umamibeef/wifi-modem/README.md

# wifi-modem
 WiFi Modem for Vintage Computers
