umamibeef/wifi-modem/pcb/board-outline.dxf

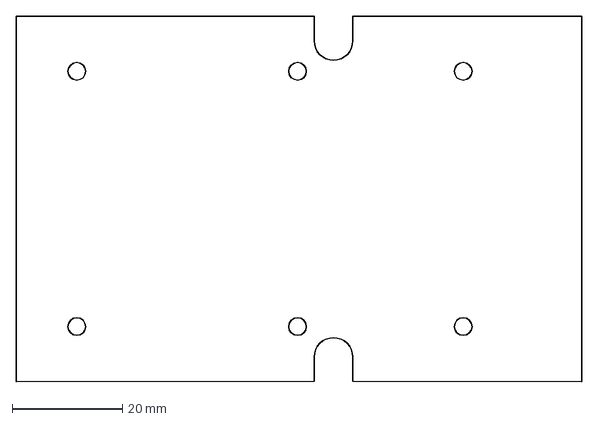
[picture p1: CAD file, 2020-07-17]
pcb/board-outline.dxf
102.5 x 66.1 mm
