umamibeef/wifi-modem/pcb/wifi-modem.pdf

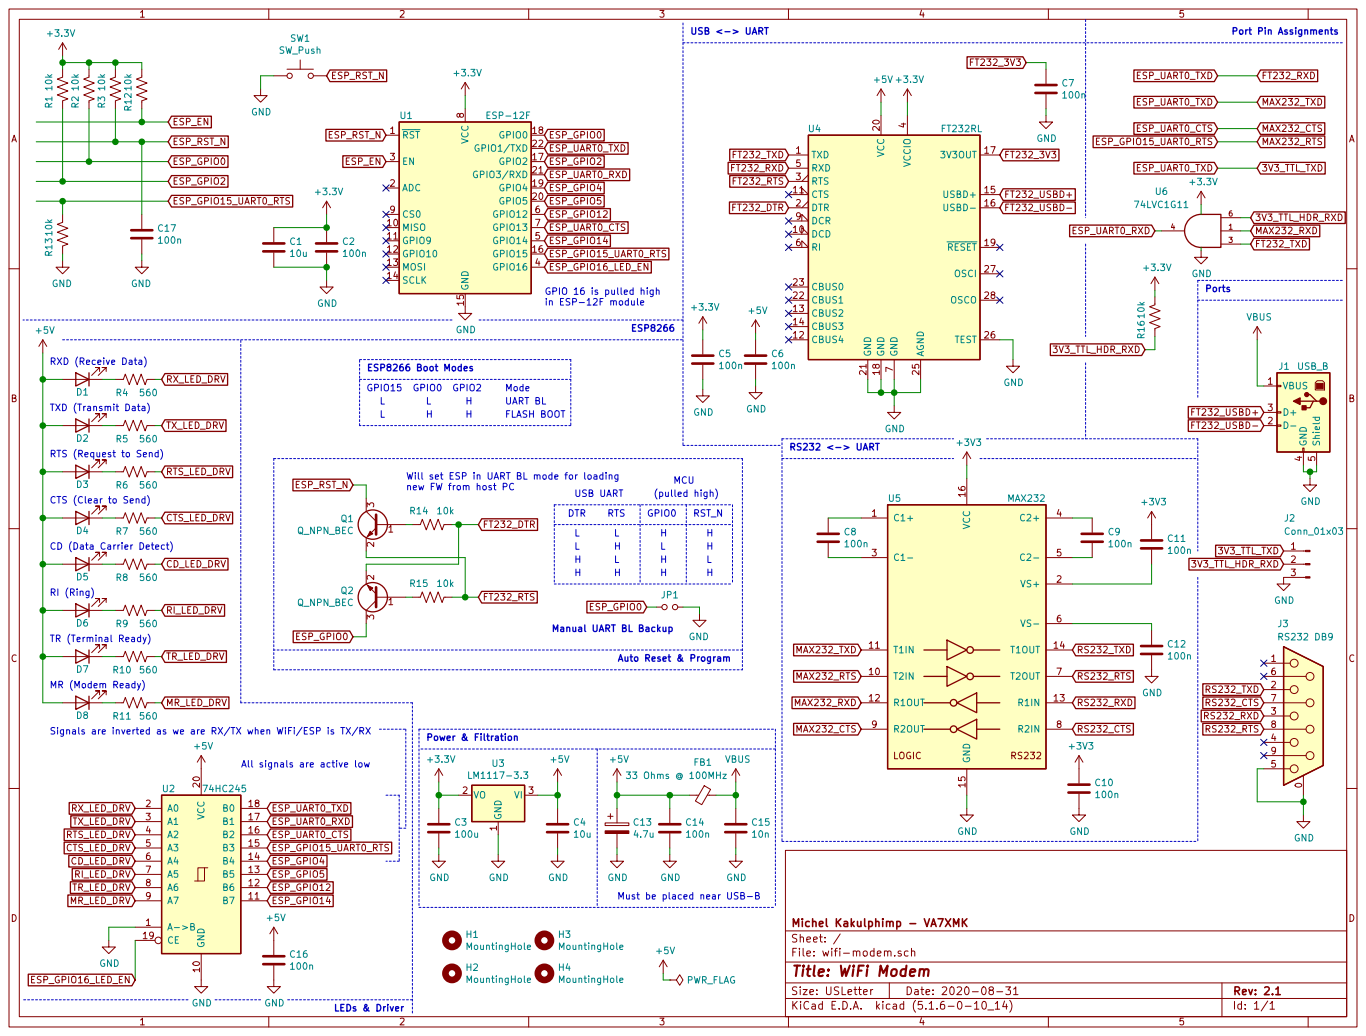
[picture p2: page 1]

GPIO 16 is pulled high

L | RST_N

L Manual UART BL Backup

CD (Data Carrier Detect)

File: wifi-modem.sch Sheet: / Michel Kakulphimp - VA7XMK

Id: 1/1 Title: WiFi Modem
