umamibeef/wifi-modem/pcb/wifi-modem-rev1p1.pdf

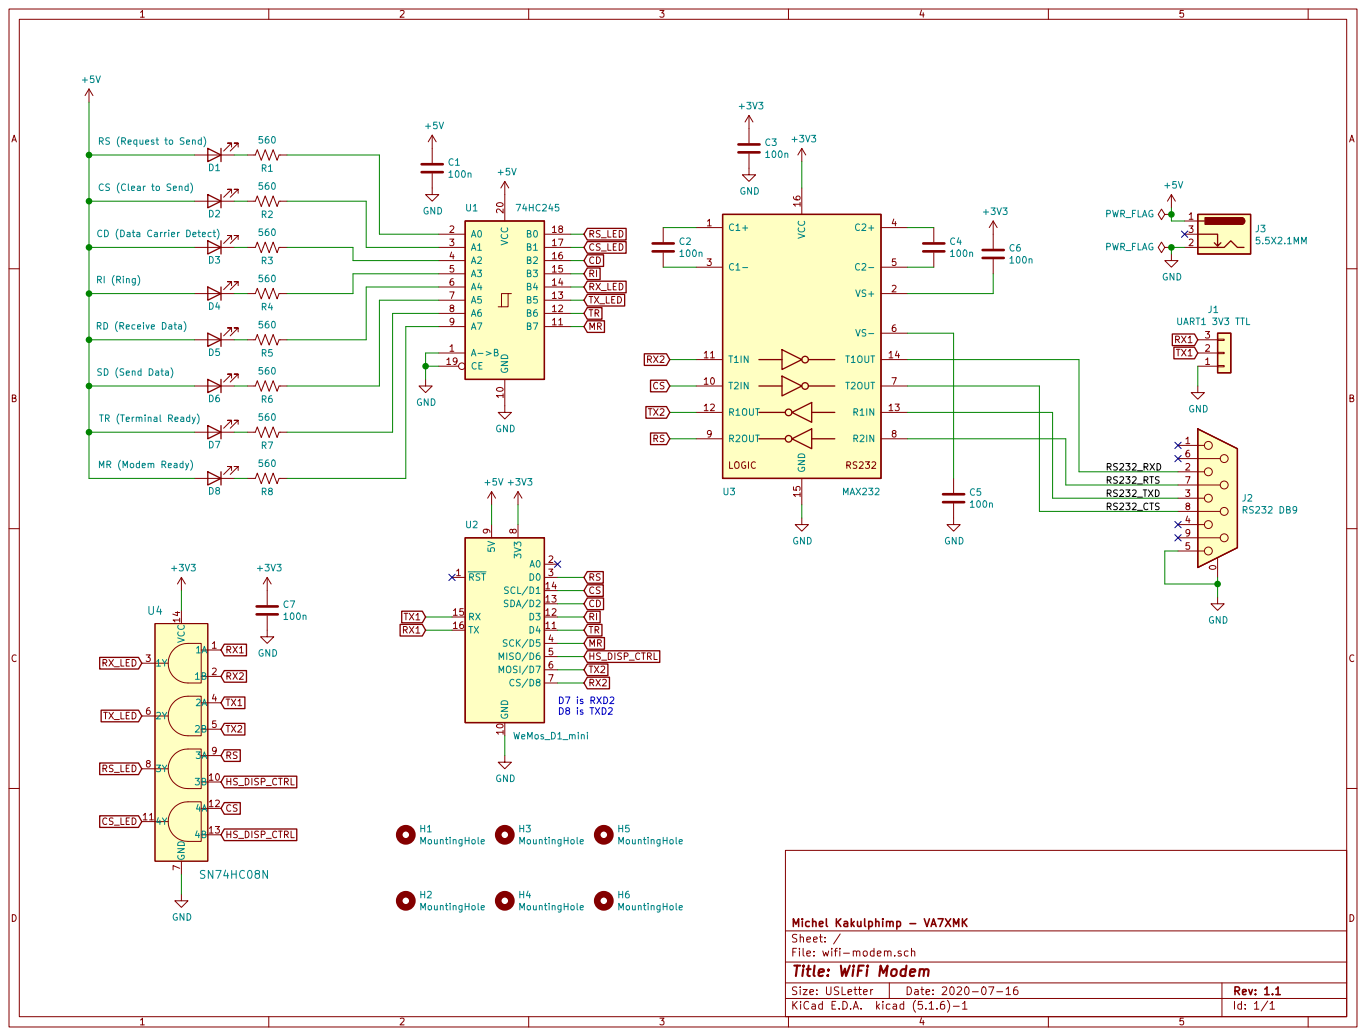
[picture p3: page 1]

File: wifi-modem.sch Sheet: / Michel Kakulphimp - VA7XMK

Id: 1/1 Title: WiFi Modem
