umamibeef/wifi-modem/pcb/wifi-modem.kicad_pcb

## KiCad design pcb/wifi-modem.kicad_pcb (2020-11-01)

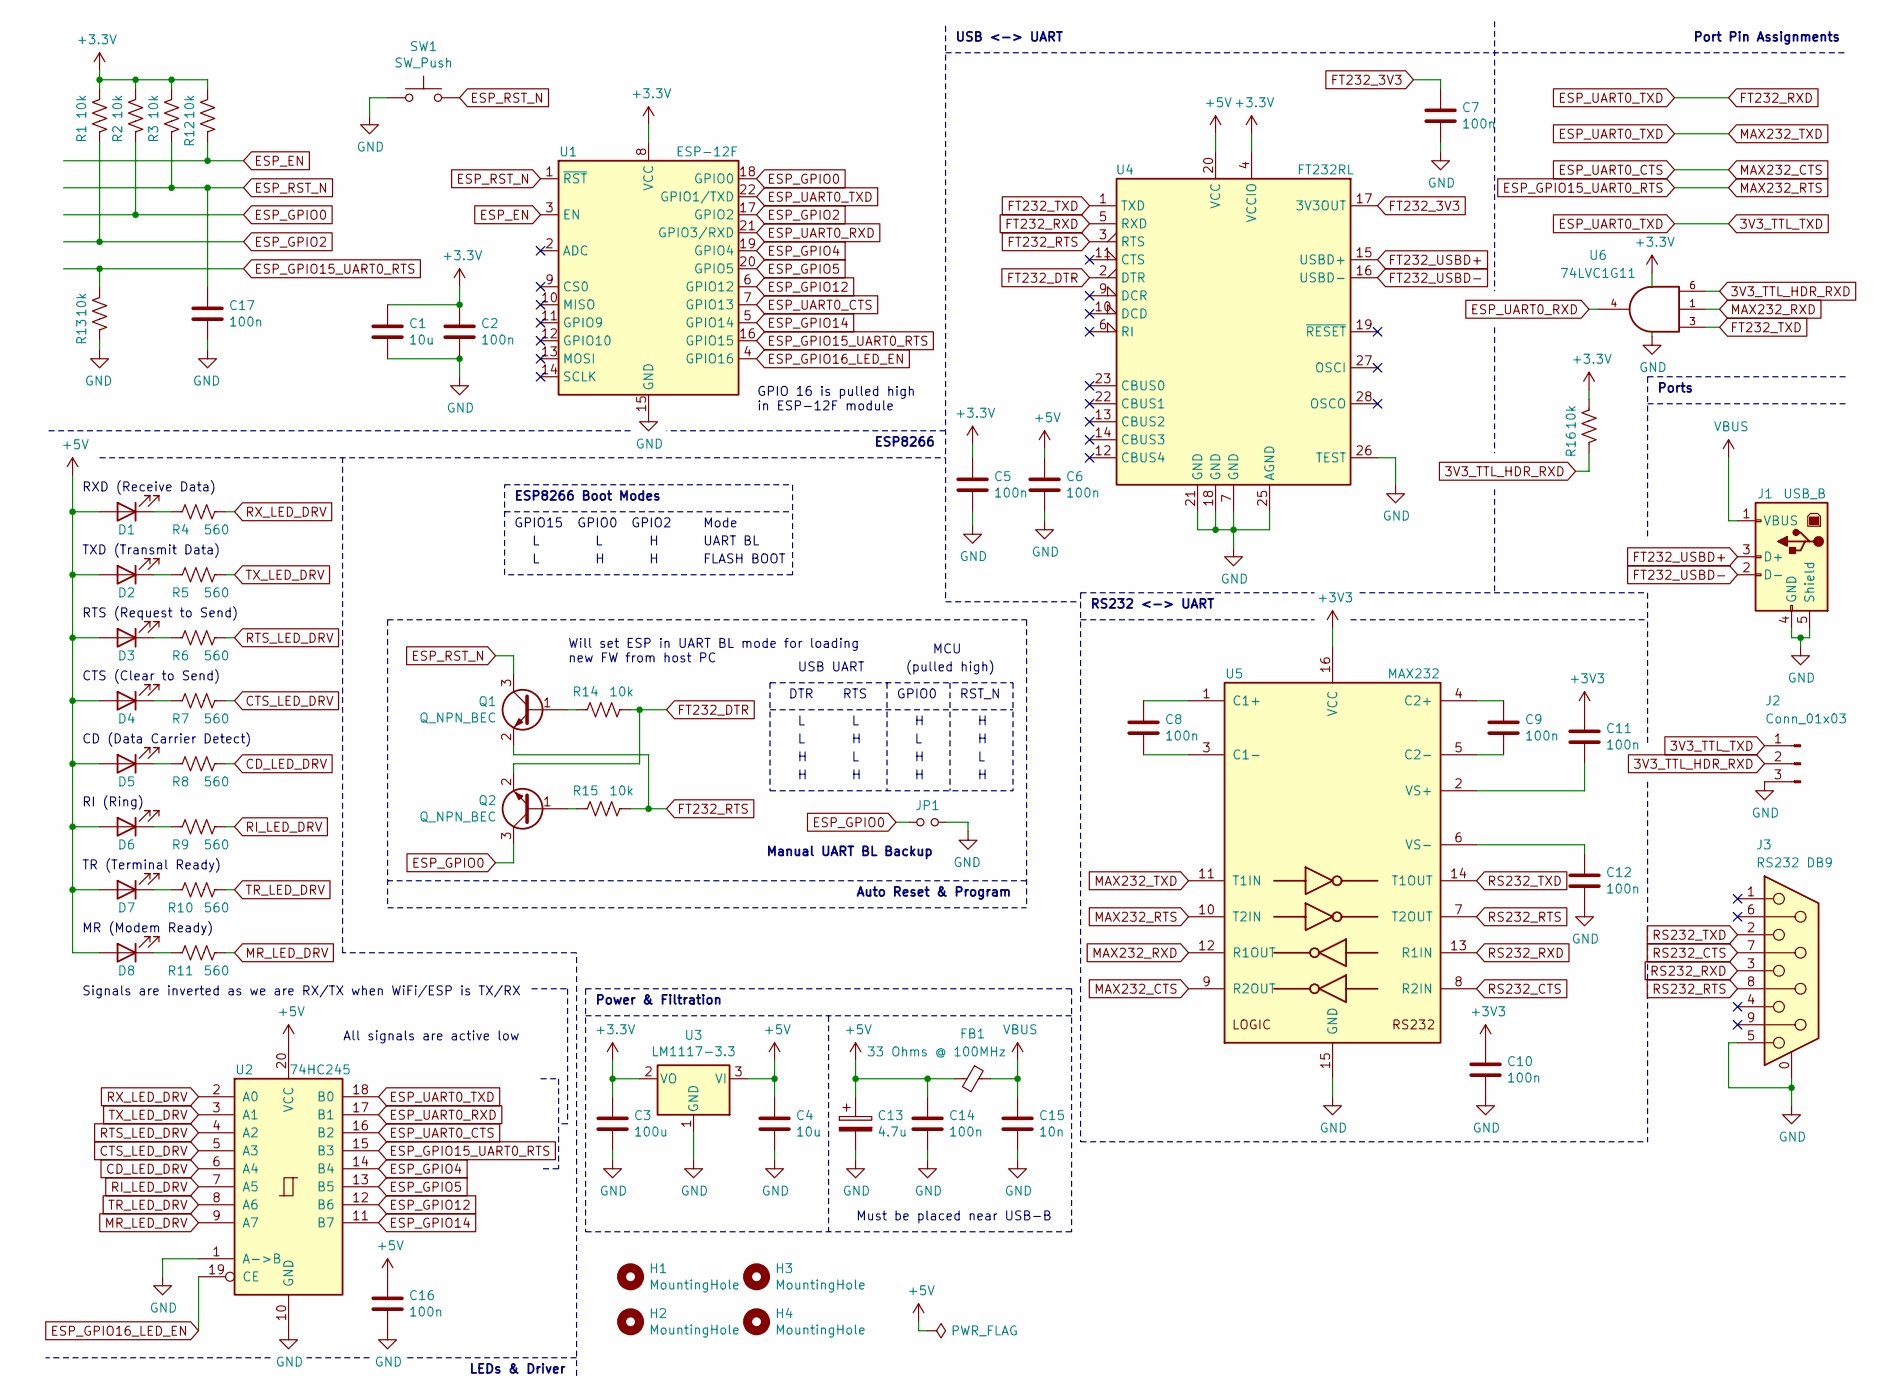
[picture p4: schematic wifi-modem.sch, WiFi Modem]

Parts:
C1, C4: 10u; C_0805_2012Metric_Pad1.15x1.40mm_HandSolder
C2, C5, C6, C7, C8, C9, C10, C11, C12, C14, C16, C17: 100n; C_0805_2012Metric_Pad1.15x1.40mm_HandSolder
C3: 100u; C_0805_2012Metric_Pad1.15x1.40mm_HandSolder
C13: 4.7u; CP_EIA-3216-18_Kemet-A_Pad1.58x1.35mm_HandSolder
C15: 10n; C_0805_2012Metric_Pad1.15x1.40mm_HandSolder
D1, D2, D3, D4, D5, D6, D7, D8: LED; LED_Rectangular_W3.9mm_H1.8mm_FlatTop
FB1: 33 Ohms @ 100MHz; L_0805_2012Metric_Pad1.15x1.40mm_HandSolder
H1, H2, H3, H4: MountingHole; MountingHole_3.2mm_M3
J1: USB_B; USB_B_OST_USB-B1HSxx_Horizontal
J2: Conn_01x03; PinHeader_1x03_P2.54mm_Vertical
J3: RS232 DB9; DSUB-9_Female_Horizontal_P2.77x2.84mm_EdgePinOffset9.90mm_H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
JP1: Jumper_NO_Small; PinHeader_1x02_P2.54mm_Vertical
Q1, Q2: Q_NPN_BEC; SOT-23_Handsoldering
R1, R2, R3, R12, R13, R14, R15, R16: 10k; R_0805_2012Metric_Pad1.15x1.40mm_HandSolder
R4, R5, R6, R7, R8, R9, R10, R11: 560; R_0805_2012Metric_Pad1.15x1.40mm_HandSolder
SW1: SW_Push; SW_SPST_PTS645
U1: ESP-12F; ESP-12E
U2: 74HC245; SOIC-20W_7.5x12.8mm_P1.27mm
U3: LM1117-3.3; SOT-223-3_TabPin2
U4: FT232RL; SSOP-28_5.3x10.2mm_P0.65mm
U5: MAX232; SOIC-16W_7.5x10.3mm_P1.27mm
U6: 74LVC1G11; SOT-23-6_Handsoldering

Connections:
3V3_TTL_HDR_RXD: J2.2, R16.2, U6.6
3V3_TTL_TXD: J2.1, U1.22 (GPIO1/TXD), U2.18 (B0), U4.5 (RXD), U5.11 (T1IN)
+5V: C4.1, C6.1, C13.1, C14.1, C16.1, D1.2 (A), D2.2 (A), D3.2 (A), D4.2 (A), D5.2 (A), D6.2 (A), D7.2 (A), D8.2 (A), FB1.2, U2.20 (VCC), U3.3 (VI), U4.20 (VCC)
CD_LED_DRV: R8.1, U2.6 (A4)
CTS_LED_DRV: R7.1, U2.5 (A3)
ESP_EN: R12.2, U1.3 (EN)
ESP_GPIO0: JP1.1, Q2.3 (C), R2.2, U1.18 (GPIO0)
ESP_GPIO2: R1.2, U1.17 (GPIO2)
ESP_GPIO4: U1.19 (GPIO4), U2.14 (B4)
ESP_GPIO5: U1.20 (GPIO5), U2.13 (B5)
ESP_GPIO12: U1.6 (GPIO12), U2.12 (B6)
ESP_GPIO14: U1.5 (GPIO14), U2.11 (B7)
ESP_GPIO15_UART0_RTS: R13.1, U1.16 (GPIO15), U2.15 (B3), U5.10 (T2IN)
ESP_GPIO16_LED_EN: U1.4 (GPIO16), U2.19 (CE)
ESP_RST_N: C17.1, Q1.3 (C), R3.2, SW1.2, U1.1 (~RST)
ESP_UART0_CTS: U1.7 (GPIO13), U2.16 (B2), U5.9 (R2OUT)
ESP_UART0_RXD: U1.21 (GPIO3/RXD), U2.17 (B1), U6.4
FT232_3V3: C7.1, U4.17 (3V3OUT)
FT232_DTR: Q2.2 (E), R14.2, U4.2 (DTR)
FT232_RTS: Q1.2 (E), R15.2, U4.3 (RTS)
FT232_TXD: U4.1 (TXD), U6.3
FT232_USBD+: J1.3 (D+), U4.15 (USBD+)
FT232_USBD-: J1.2 (D-), U4.16 (USBD-)
GND: C1.2, C2.2, C3.2, C4.2, C5.2, C6.2, C7.2, C10.2, C12.2, C13.2, C14.2, C15.2, C16.2, C17.2, J1.4 (GND), J1.5 (Shield), J2.3, J3.0 (PAD), J3.5, JP1.2, R13.2, SW1.1, U1.15 (GND), U2.1 (A->B), U2.10 (GND), U3.1 (GND), U4.7 (GND), U4.18 (GND), U4.21 (GND), U4.25 (AGND), U4.26 (TEST), U5.15 (GND), U6.2 (GND)
MAX232_RXD: U5.12 (R1OUT), U6.1
MR_LED_DRV: R11.1, U2.9 (A7)
unnamed: C8.1, U5.1 (C1+)
unnamed: C8.2, U5.3 (C1-)
unnamed: C9.1, U5.4 (C2+)
unnamed: C9.2, U5.5 (C2-)
unnamed: C11.2, U5.2 (VS+)
unnamed: C12.1, U5.6 (VS-)
unnamed: D1.1 (K), R4.2
unnamed: D2.1 (K), R5.2
unnamed: D3.1 (K), R6.2
unnamed: D4.1 (K), R7.2
unnamed: D5.1 (K), R8.2
unnamed: D6.1 (K), R9.2
unnamed: D7.1 (K), R10.2
unnamed: D8.1 (K), R11.2
unnamed: Q1.1 (B), R14.1
unnamed: Q2.1 (B), R15.1
RI_LED_DRV: R9.1, U2.7 (A5)
RS232_CTS: J3.7, U5.8 (R2IN)
RS232_RTS: J3.8, U5.7 (T2OUT)
RS232_RXD: J3.3, U5.13 (R1IN)
RS232_TXD: J3.2, U5.14 (T1OUT)
RTS_LED_DRV: R6.1, U2.4 (A2)
RX_LED_DRV: R4.1, U2.2 (A0)
TR_LED_DRV: R10.1, U2.8 (A6)
TX_LED_DRV: R5.1, U2.3 (A1)
VBUS: C15.1, FB1.1, J1.1 (VBUS)

Notes on the sheet:
MR (Modem Ready)
TR (Terminal Ready)
TXD (Transmit Data)
RXD (Receive Data)
RI (Ring)
CD (Data Carrier Detect)
CTS (Clear to Send)
RTS (Request to Send)
GPIO15
GPIO0
GPIO2
Mode
UART BL
FLASH BOOT
Auto Reset & Program
ESP8266 Boot Modes
RST_N
RTS
DTR
Signals are inverted as we are RX/TX when WiFi/ESP is TX/RX
All signals are active low
MCU
USB UART
Will set ESP in UART BL mode for loading new FW from host PC
(pulled high)
Power & Filtration
Must be placed near USB-B
Port Pin Assignments
Ports
ESP8266
LEDs & Driver
USB <-> UART
RS232 <-> UART
GPIO 16 is pulled high in ESP-12F module
Manual UART BL Backup

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
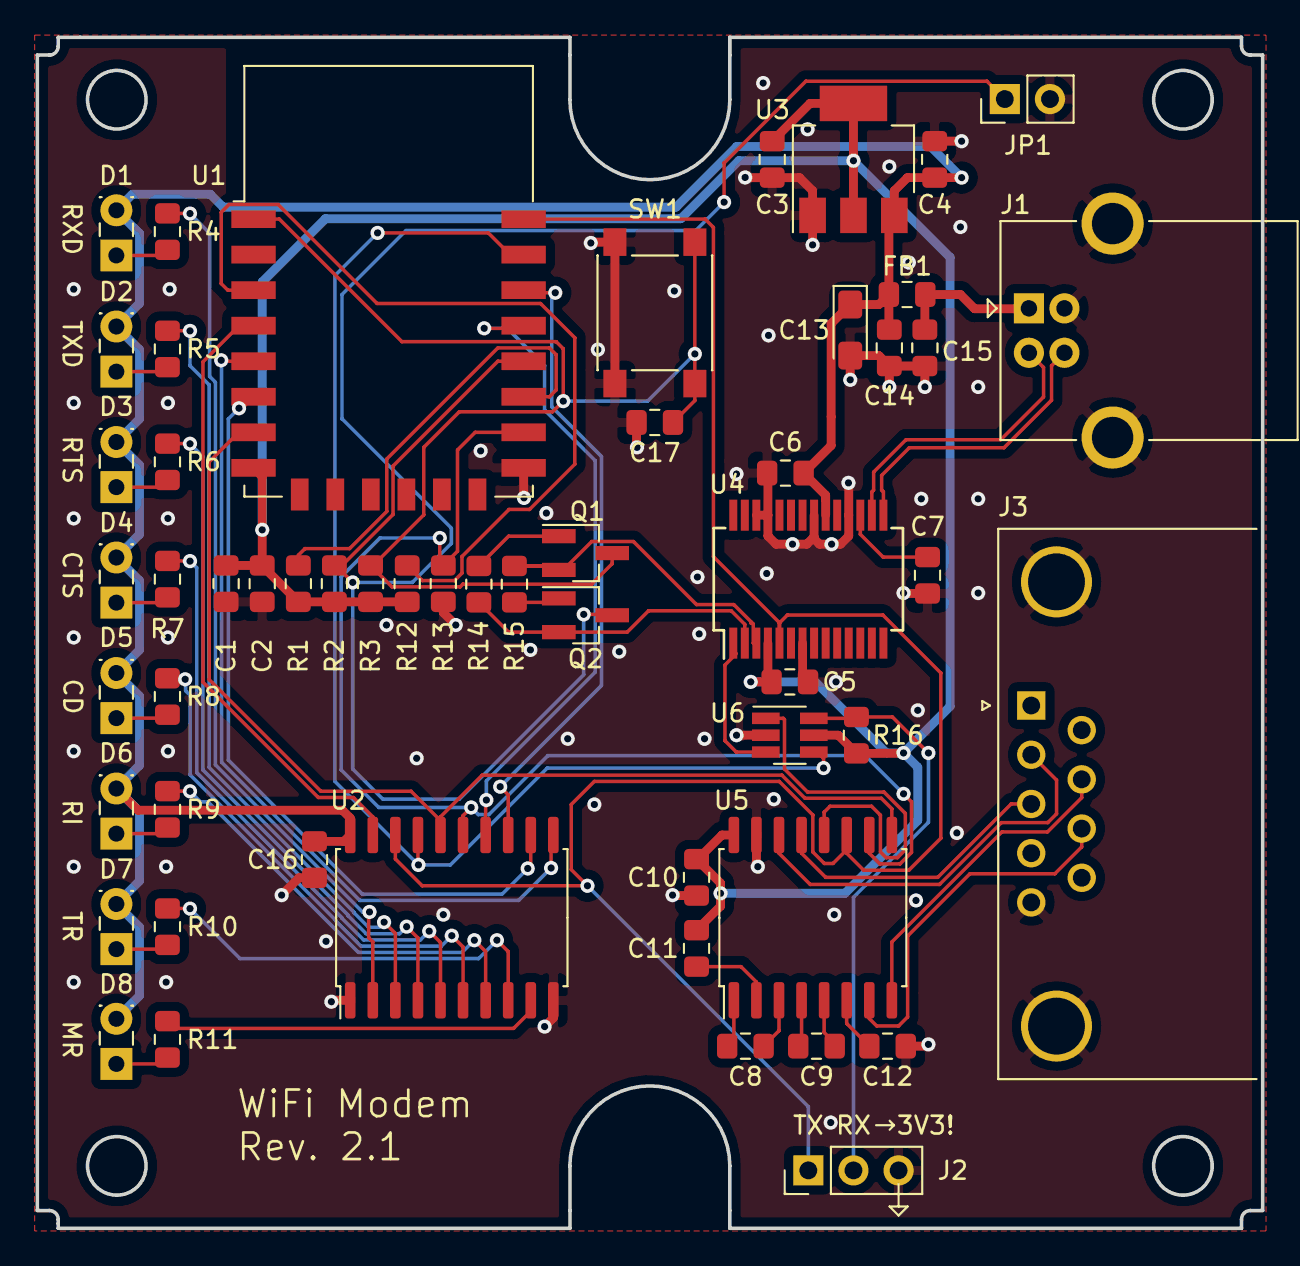
[picture p5: board wifi-modem.kicad_pcb from above]

Board: 2 copper layers, 69.0 x 67.0 mm, 59 parts (0 on the bottom side), 53 nets.
