umamibeef/wifi-modem/(commit log)

2020-07-17 Rev 1.1
    * Cleaning up schematic
    * Adding missing copper void
    * Added net names for RS232 signals
    [wifi-modem.kicad_pcb, wifi-modem.sch]
2020-08-27 Initial commit of rev 2.0
    * WeMo dev board has been deconstructed into layout
    * FT232L for USB -> UART
    * USB-B port for power/debug
    * Native HW handshaking implementation
    [wifi-modem.sch]
2020-08-27 PCB layout + footprint changes
    [wifi-modem.kicad_pcb, wifi-modem.sch]
2020-08-27 Updating date and fixing swapped MAX232 pins
    [wifi-modem.sch]
2020-08-31 Added 100nF cap between RST_N and GND and additional 10uF cap near 3.3V rail of ESP module
    [wifi-modem.kicad_pcb, wifi-modem.sch]
2020-08-31 Rotating VBUS filter
    [wifi-modem.kicad_pcb]
2020-08-31 Updating date
    [wifi-modem.sch]
2020-10-28 Updating PDF of schematic
2020-10-28 Added transceiver control
    [wifi-modem.kicad_pcb, wifi-modem.sch]
2020-10-29 Updating schematic
2020-10-29 Changing VCCIO supply to external 3V3 LDO
    [wifi-modem.kicad_pcb, wifi-modem.sch]
2020-10-30 Rev 2.1 updates
    * Added 3-input AND to handle 3x serial inputs
    * Added manual UART BL mode jumper
    * Changed footprint of 2 transistors
    * Updated refdes of caps
    * Using 3V3 LDO for FT232RL IO
    [wifi-modem.kicad_pcb, wifi-modem.sch]
2020-10-31 Saving work
    [wifi-modem.kicad_pcb]
2020-11-01 Finished layout for 2.1
    [wifi-modem.kicad_pcb]
2020-11-01 Final tweaks
    [wifi-modem.kicad_pcb]
2020-11-01 Fixing fill
    [wifi-modem.kicad_pcb]
2020-11-01 Updating PDF
    [wifi-modem.kicad_pcb]
